interreg-nomade/IMU-v2-Hardware/README.md

# IMU-v2-Hardware

Design files can be found [here](/Design)

Manufacturing files can be found [here](/Gerber)

### Photos
Photos can be found [here](/Photos)

<p align="center">  
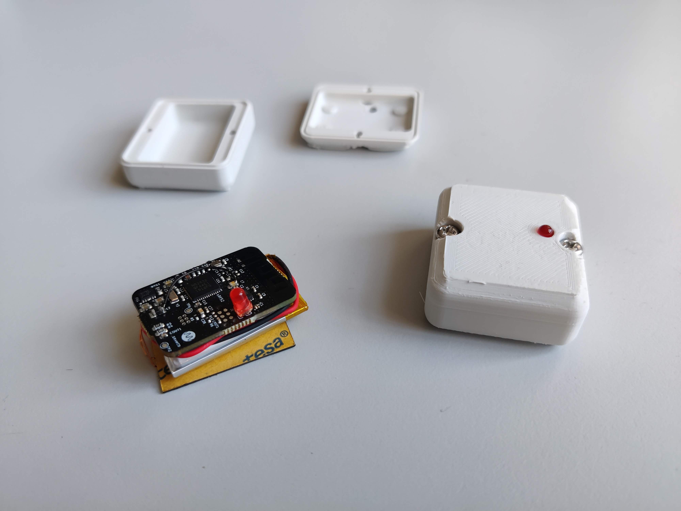
[picture p1: Photos/Internals1.jpg]

</p>
