interreg-nomade/IMU-v2-Hardware/Photos/Back.jpg

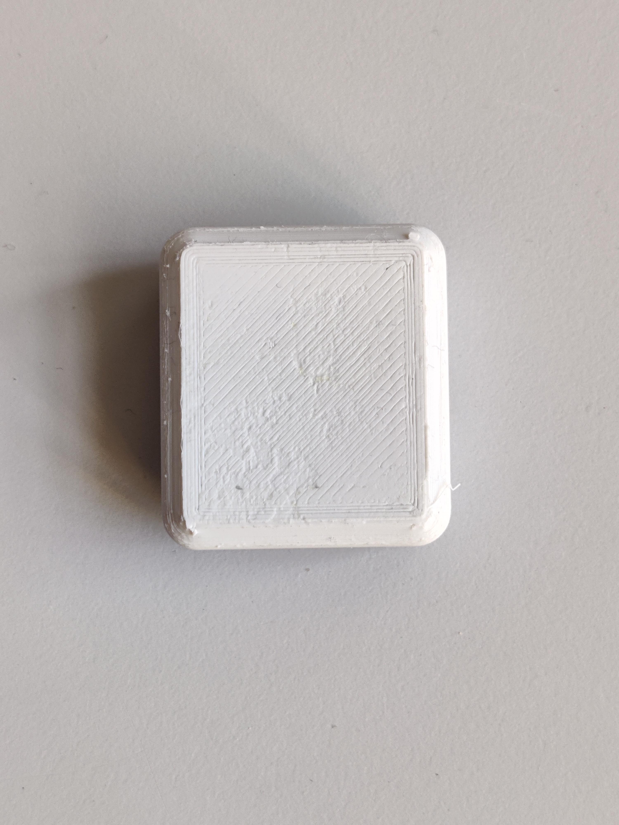
Photos/Back.jpg
