interreg-nomade/IMU-v2-Hardware/Photos/Front.jpg

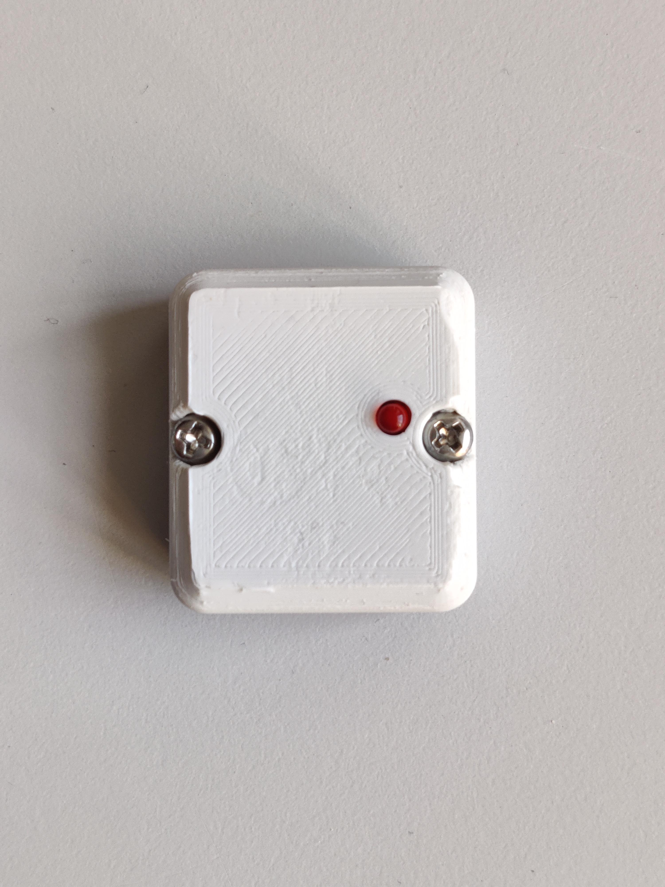
Photos/Front.jpg
