interreg-nomade/IMU-v2-Hardware/Photos/Internals2.jpg

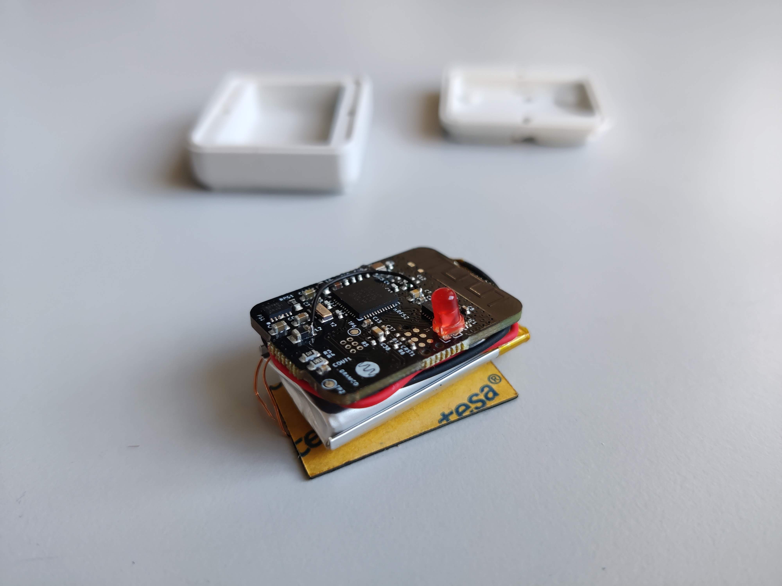
Photos/Internals2.jpg
