interreg-nomade/IMU-v2-Hardware/Photos/Internals_Bottom.jpg

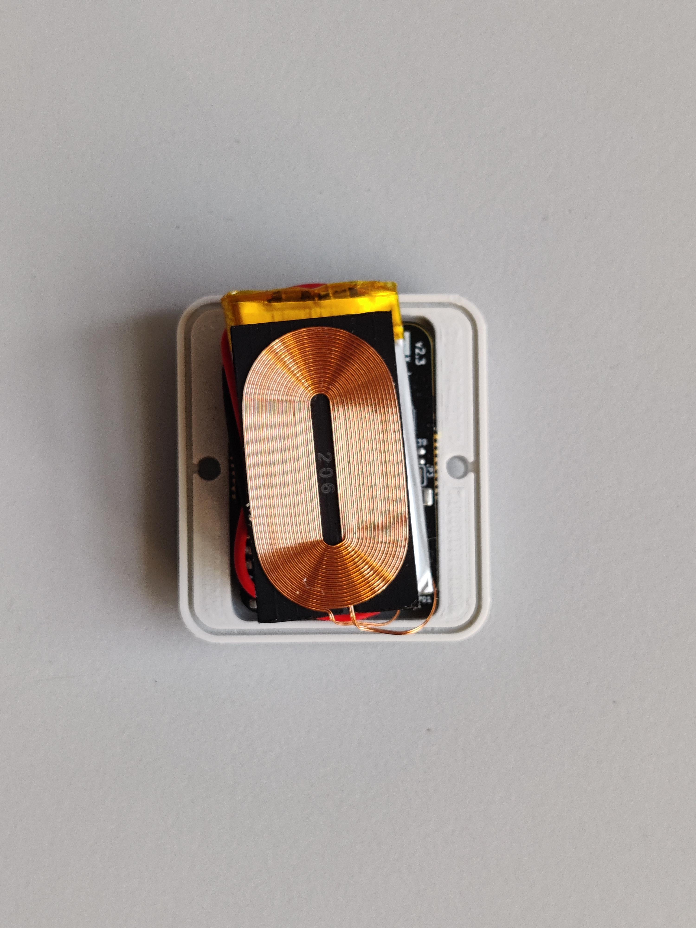
Photos/Internals_Bottom.jpg
