interreg-nomade/IMU-v2-Hardware/Photos/Internals_Top.jpg

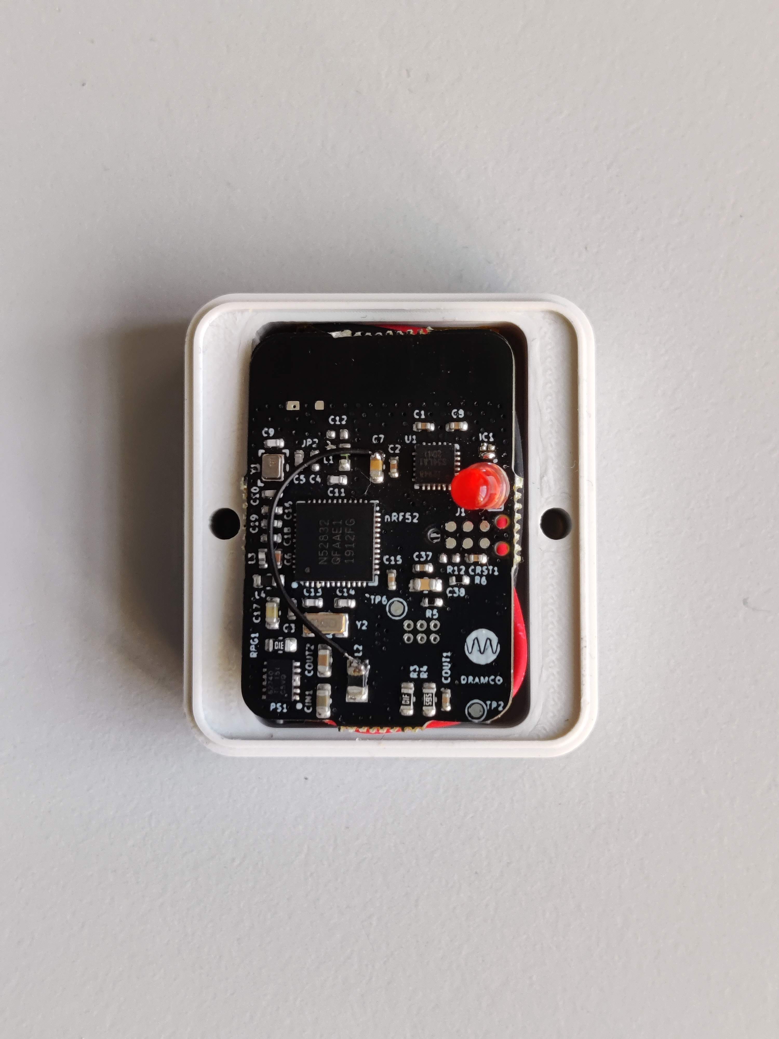
Photos/Internals_Top.jpg
