interreg-nomade/IMU-v2-Hardware/Photos/Side1.jpg

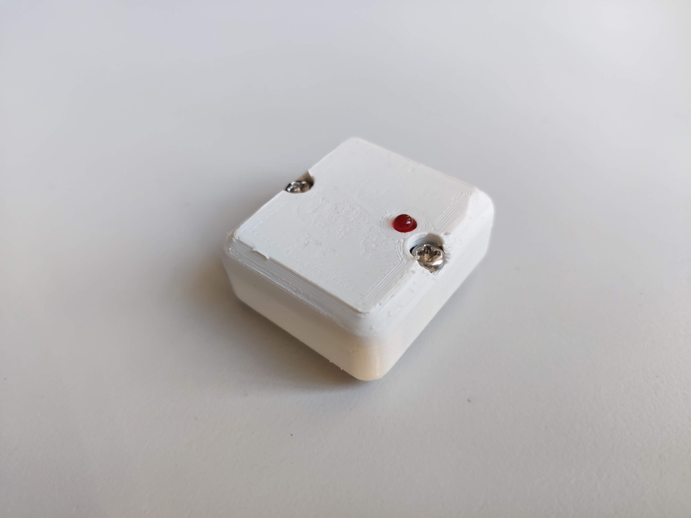
Photos/Side1.jpg
