interreg-nomade/IMU-v2-Hardware/Photos/Side2.jpg

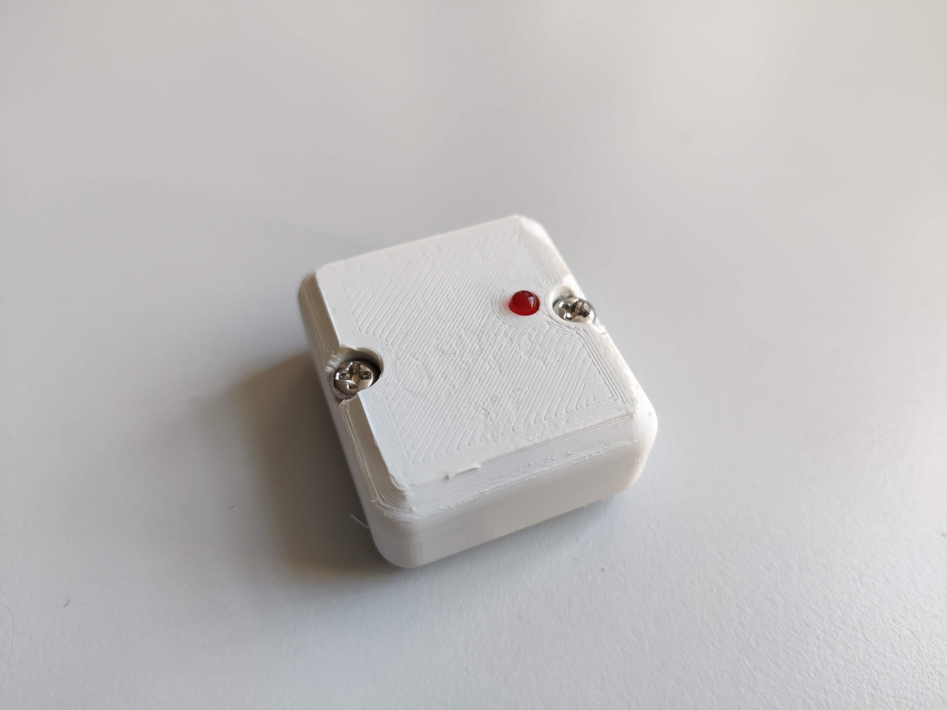
Photos/Side2.jpg
