interreg-nomade/IMU-v2-Hardware/Case/Top.STL

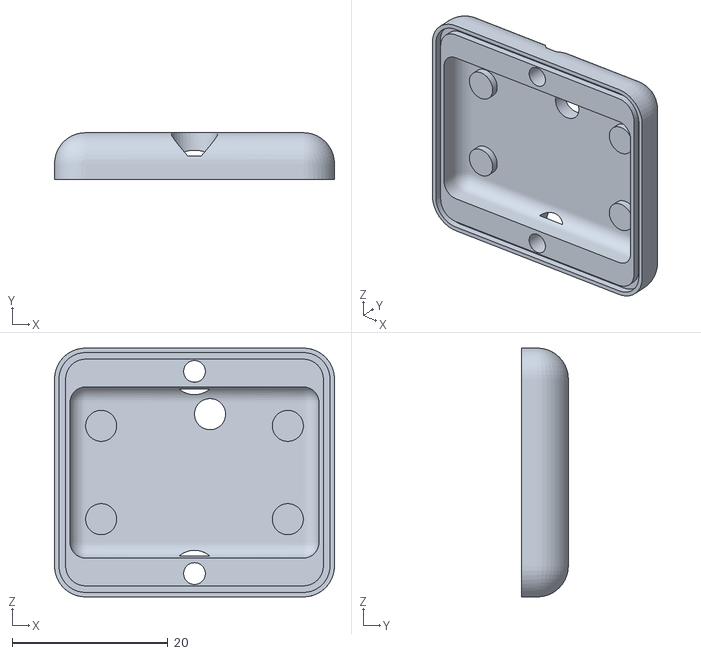
[picture p9: CAD file, 2022-03-03]
Case/Top.STL
36.0 x 6.00 x 32.0
