interreg-nomade/IMU-v2-Hardware/Case/Bottom.STL

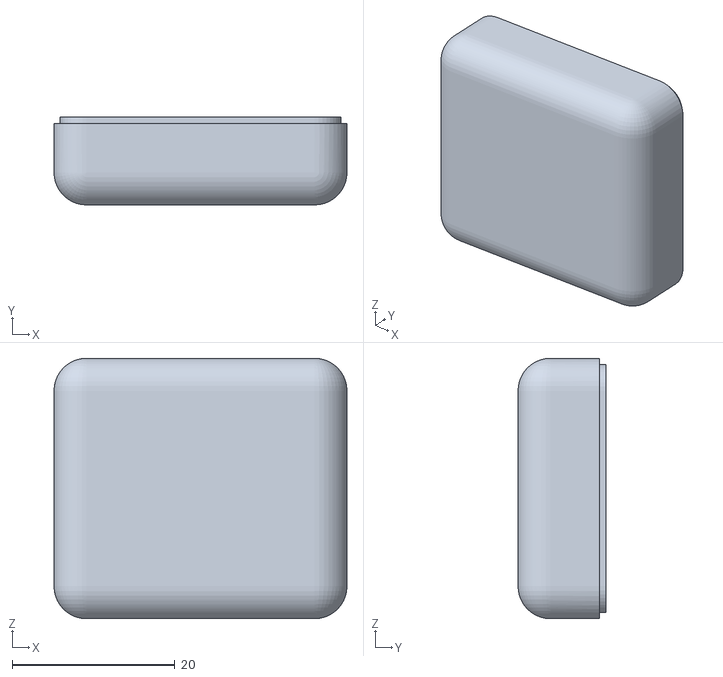
[picture p10: CAD file, 2022-03-03]
Case/Bottom.STL
36.0 x 10.8 x 32.0
