interreg-nomade/IMU-v2-Hardware/Design/NOMADe_IMU_v2_3.kicad_pcb

## KiCad design Design/NOMADe_IMU_v2_3.kicad_pcb (2022-03-03)

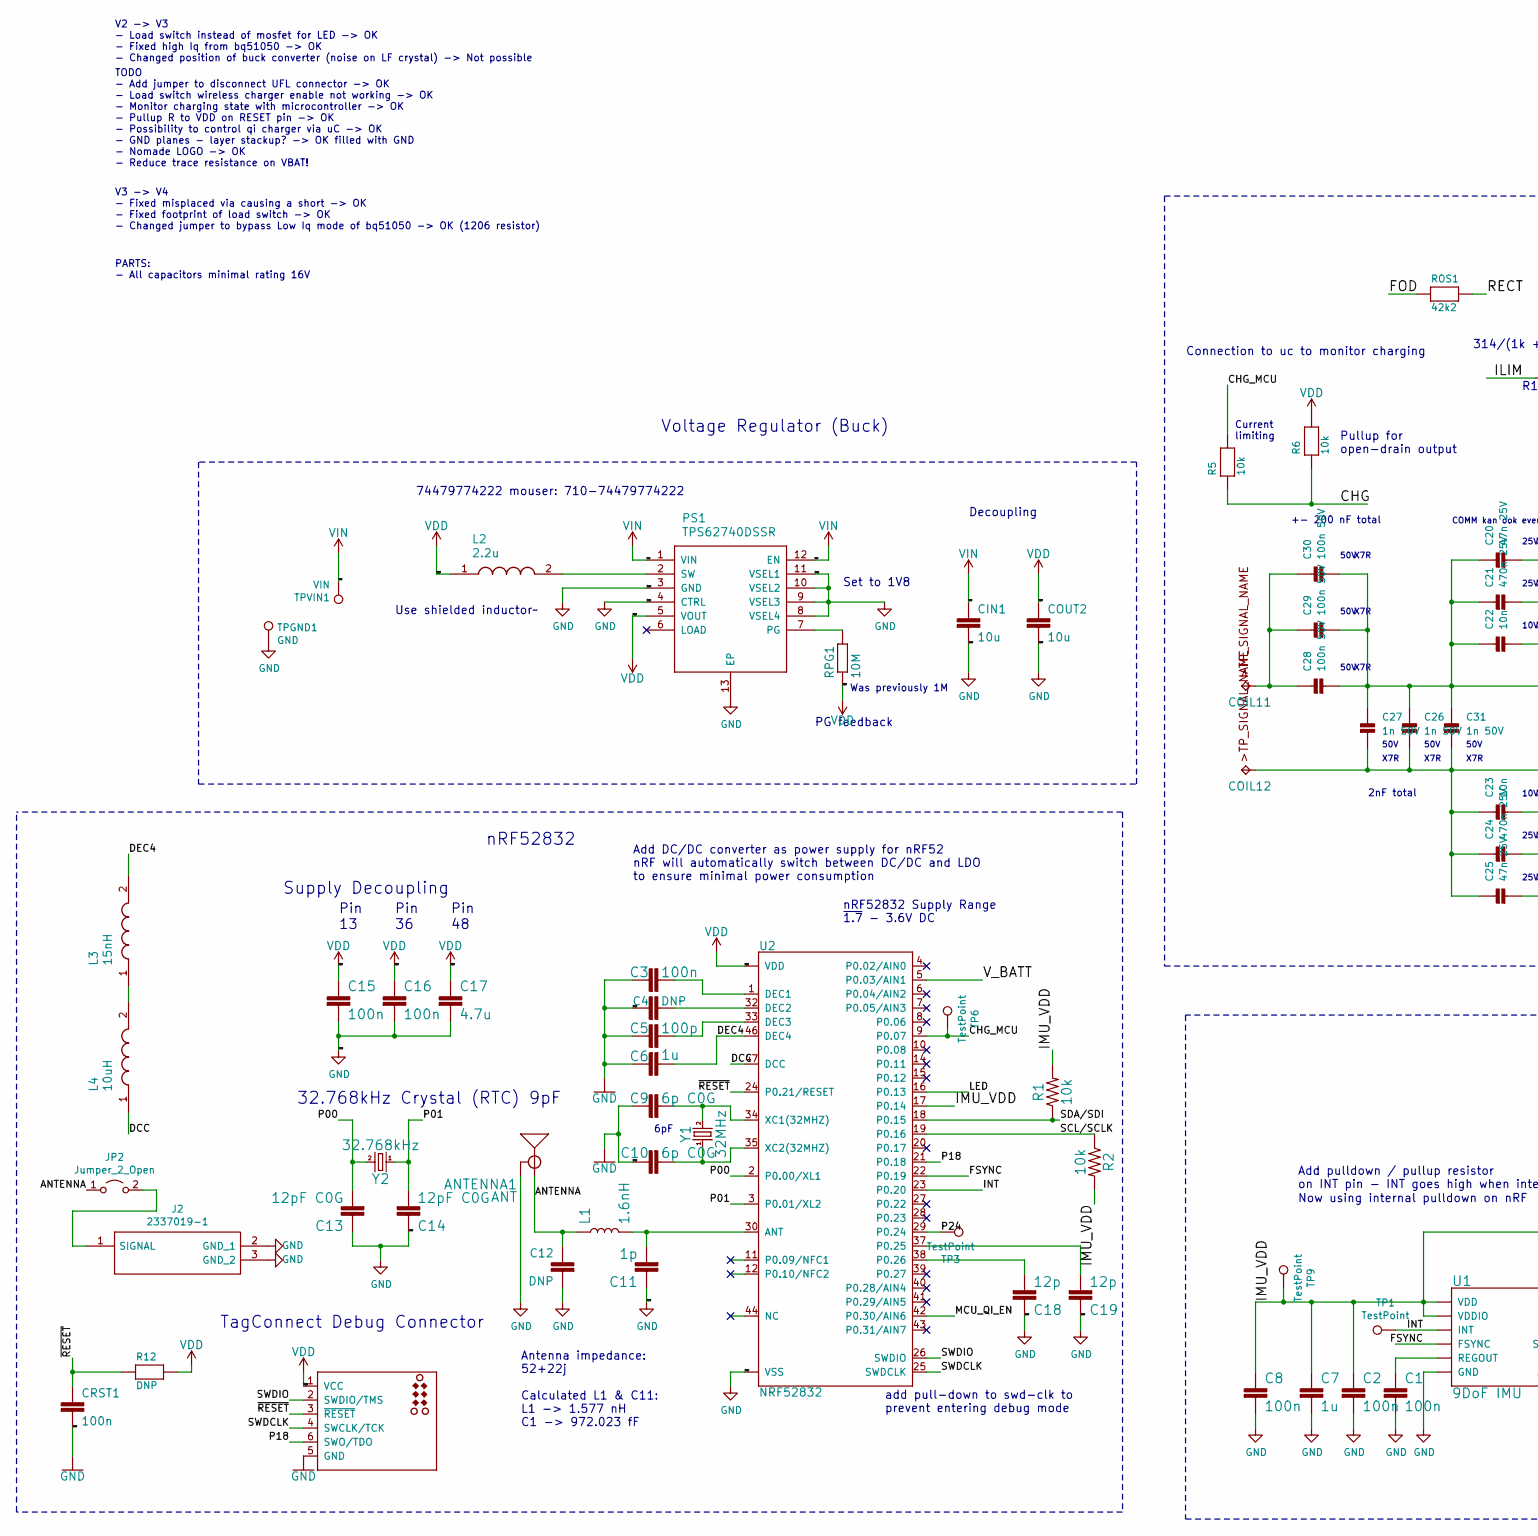
[picture p11: schematic NOMADe_IMU_v2_3.sch, NOMADe IMU v2.0, part in row 1, column 1]

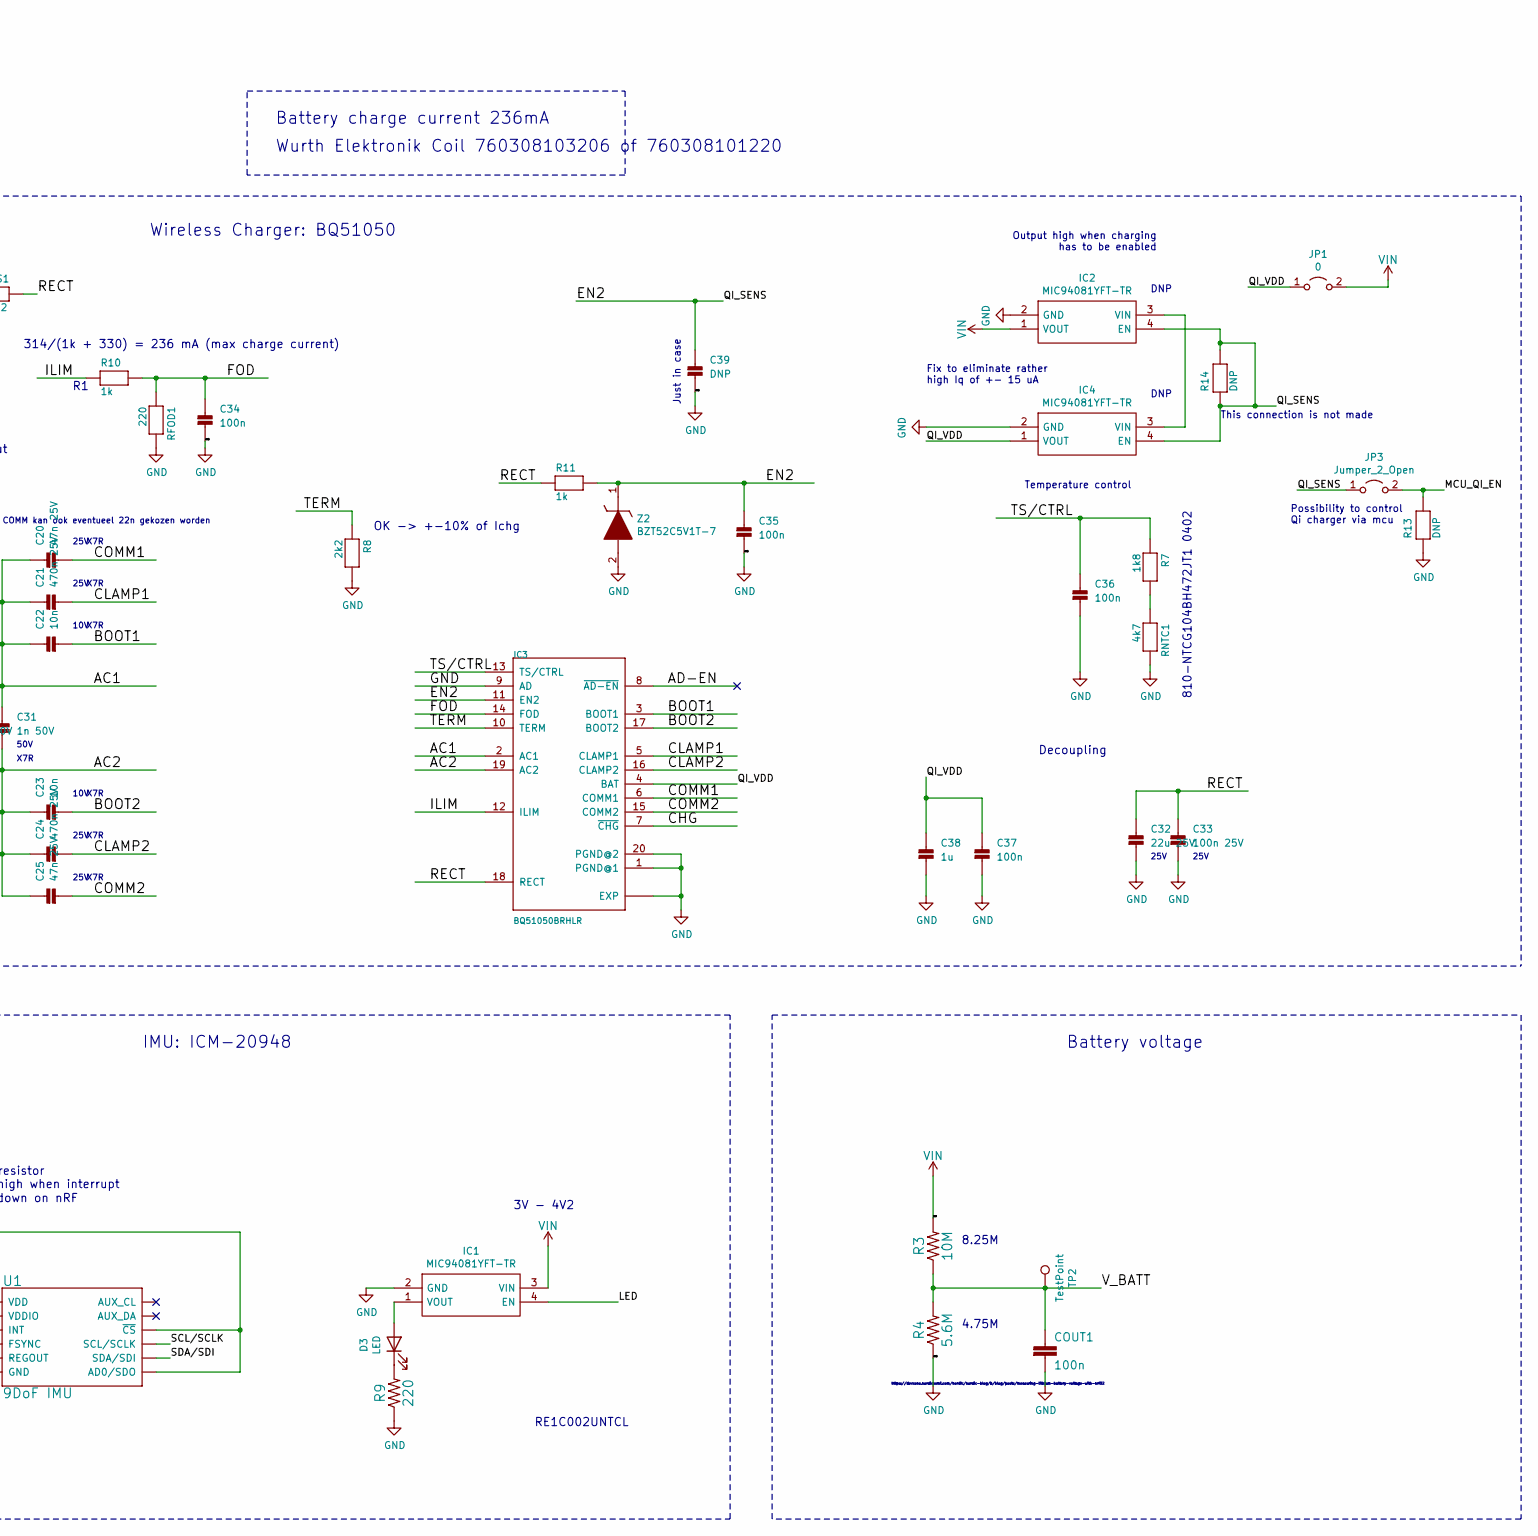
[picture p12: schematic NOMADe_IMU_v2_3.sch, NOMADe IMU v2.0, part in row 1, column 2]

Parts:
ANTENNA1: ANT; TRACE_ANTENNA_2.4GHZ_15.2MM
C1, C2, C3, C8, C15, C16, C34, C35, C36, C37: 100n; C_0402_1005Metric
C4, C12, C39: DNP; C_0402_1005Metric
C5: 100p; C_0402_1005Metric
C6: 1u; C_0402_1005Metric
C7, C38: 1u; C_0603_1608Metric
C9, C10: 6p C0G; C_0402_1005Metric
C11: 1p; C_0402_1005Metric
C13, C14: 12pF C0G; C_0402_1005Metric
C17: 4.7u; C_0603_1608Metric
C18, C19: 12p; C_0402_1005Metric
C20, C25: 47n 25V; C_0603_1608Metric
C21, C24: 470n 25V; C_0603_1608Metric
C22, C23: 10n; C_0603_1608Metric
C26, C27, C31: 1n 50V; C_0603_1608Metric
C28, C29, C30: 100n 50V; C_0603_1608Metric
C32: 22u 25V; C_0805_2012Metric
C33: 100n 25V; C_0402_1005Metric
CIN1: 10u; C_0603_1608Metric
COIL11, COIL12: TPTP10SQ; TP10SQ
COUT1: 100n; C_0402_1005Metric
COUT2: 10u; C_0603_1608Metric
CRST1: 100n; C_0402_1005Metric
D3: LED; PinHeader_1x02_P1.27mm_Vertical
IC1, IC2, IC4: MIC94081YFT-TR; Mouser Part Number 998-MIC94081YFTTR
IC3: BQ51050BRHLR; QFN50P450X350X100-21N
J1: TC2030_SWD-MCP-NL; TC2030-MCP-NL
J2: 2337019-1; 23370191; Mouser Part Number 571-2337019-1
JP1: 0; R_1206_3216Metric
JP2: Jumper_2_Open; R_0402_1005Metric
JP3: Jumper_2_Open; SMT-JUMPER_2_NO_SILK
L1: 1.6nH; 0402
L2: 2.2u; INDC2012X145N
L3: 15nH; L_0402_1005Metric
L4: 10uH; L_0603_1608Metric
PS1: TPS62740DSSR; SON50P200X300X80-13N
R1, R2, R5, R6: 10k; C_0402_1005Metric
R3: 10M; R_0603_1608Metric
R4: 5.6M; R_0603_1608Metric
R7: 1k8; R_0402_1005Metric
R8: 2k2; R_0603_1608Metric
R9: 220; R_0402_1005Metric
R10, R11: 1k; R_0603_1608Metric
R12, R13: DNP; C_0402_1005Metric
R14: DNP; R_0603_1608Metric
RFOD1: 220; R_0603_1608Metric
RNTC1: 4k7; R_0402_1005Metric
ROS1: 42k2; R_0603_1608Metric
RPG1: 10M; R_0603_1608Metric
TP1, TP2, TP3, TP6, TP9: TestPoint; TestPoint_Pad_D1.0mm
TPGND1: GND; TestPoint_Pad_2.0x2.0mm
TPVIN1: VIN; TestPoint_Pad_2.0x2.0mm
U1: 9DoF IMU; QFN24-3X3
U2: NRF52832; QFN48-6X6MM
Y1: 32MHz; CRYSTAL-SMD-2.0X1.6MM
Y2: 32.768kHz; CRYSTAL-SMD-3.2X1.5MM
Z2: BZT52C5V1T-7; SODFL1608X65N; Mouser Part Number 621-BZT52C5V1T-7

Connections:
/AC1: C20.1, C21.1, C22.1, C26.1, C27.1, C28.2, C29.2, C30.2, C31.1, IC3.2 (AC1)
/AC2: C23.1, C24.1, C25.1, C26.2, C27.2, C31.2, COIL12.TP, IC3.19 (AC2)
/AD-EN: IC3.8 (~AD-EN)
/ANTENNA: ANTENNA1.ANT (SIGNAL), C12.1, JP2.1 (A), L1.1
/BOOT1: C22.2, IC3.3 (BOOT1)
/BOOT2: C23.2, IC3.17 (BOOT2)
/CHG: IC3.7 (~CHG), R5.1, R6.1
/CHG_MCU: R5.2, TP6.1, U2.9 (P0.07)
/CLAMP1: C21.2, IC3.5 (CLAMP1)
/CLAMP2: C24.2, IC3.16 (CLAMP2)
/COMM1: C20.2, IC3.6 (COMM1)
/COMM2: C25.2, IC3.15 (COMM2)
/DCC: L4.1, U2.47 (DCC)
/DEC4: C6.2, L3.2, U2.46 (DEC4)
/EN2: C35.1, C39.1, IC2.4 (EN), IC3.11 (EN2), IC4.4 (EN), JP3.1 (A), R11.2, R14.1, R14.2, Z2.1
/FOD: C34.1, IC3.14 (FOD), R10.2, RFOD1.1, ROS1.1
/FSYNC: U1.11 (FSYNC), U2.22 (P0.19)
/ILIM: IC3.12 (ILIM), R10.1
/IMU_VDD: C2.1, C7.1, C8.1, R1.2, R2.2, TP9.1, U1.8 (VDDIO), U1.9 (AD0/SDO), U1.13 (VDD), U1.22 (~CS), U2.17 (P0.14)
/INT: TP1.1, U1.12 (INT), U2.23 (P0.20)
/LED: IC1.4 (EN), U2.16 (P0.13)
/MCU_QI_EN: JP3.2 (B), R13.2, U2.42 (P0.30/AIN6)
/P00: C13.2, U2.2 (P0.00/XL1), Y2.P$2 (2)
/P01: C14.2, U2.3 (P0.01/XL2), Y2.P$1 (1)
/P18: J1.6 (SWO/TDO), U2.21 (P0.18)
/P24: TP3.1, U2.29 (P0.24)
/QI_VDD: C37.1, C38.1, IC3.4 (BAT), IC4.1 (VOUT), JP1.1 (A)
/RECT: C32.1, C33.1, IC3.18 (RECT), R11.1, ROS1.2
/SCL/SCLK: R2.1, U1.23 (SCL/SCLK), U2.19 (P0.16)
/SDA/SDI: R1.1, U1.24 (SDA/SDI), U2.18 (P0.15)
/SWDCLK: J1.4 (SWCLK/TCK), U2.25 (SWDCLK)
/SWDIO: J1.2 (SWDIO/TMS), U2.26 (SWDIO)
/TERM: IC3.10 (TERM), R8.1
/TS/CTRL: C36.1, IC3.13 (TS/CTRL), R7.1
/V_BATT: COUT1.1, R3.1, R4.2, TP2.1, U2.5 (P0.03/AIN1)
/~RESET~: CRST1.1, J1.3 (~RESET), R12.1, U2.24 (P0.21/RESET)
GND: ANTENNA1.GND, C1.2, C2.2, C3.1, C4.1, C5.1, C6.1, C7.2, C8.2, C9.1, C10.2, C11.1, C12.2, C13.1, C14.1, C15.2, C16.2, C17.2, C18.1, C19.1, C32.2, C33.2, C34.2, C35.2, C36.2, C37.2, C38.2, C39.2, CIN1.2, COUT1.2, COUT2.2, CRST1.2, IC1.2 (GND), IC2.2 (GND), IC3.1 (PGND@1), IC3.9 (AD), IC3.20 (PGND@2), IC3.21 (EXP), IC3.22 (EXP), IC3.23 (EXP), IC3.24 (EXP), IC3.25 (EXP), IC3.26 (EXP), IC3.27 (EXP), IC3.28 (EXP), IC3.29 (EXP), IC3.30 (EXP), IC3.31 (EXP), IC3.32 (EXP), IC3.33 (EXP), IC4.2 (GND), J1.5 (GND), J2.2 (GND_1), J2.3 (GND_2), PS1.3 (GND), PS1.4 (CTRL), PS1.8 (VSEL4), PS1.9 (VSEL3), PS1.10 (VSEL2), PS1.11 (VSEL1), PS1.13 (EP), R4.1, R8.2, R9.1, R13.1, RFOD1.2, RNTC1.2, TPGND1.1, U1.18 (GND), U1.20 (GND), U2.31 (VSS), U2.45 (VSS), U2.EP (VSS), Z2.2
unnamed: C1.1, U1.10 (REGOUT)
unnamed: C3.2, U2.1 (DEC1)
unnamed: C4.2, U2.32 (DEC2)
unnamed: C5.2, U2.33 (DEC3)
unnamed: C9.2, U2.34 (XC1(32MHZ)), Y1.3 (2)
unnamed: C10.1, U2.35 (XC2(32MHZ)), Y1.1
unnamed: C11.2, L1.2, U2.30 (ANT)
unnamed: C18.2, U2.38 (P0.26)
unnamed: C19.2, U2.37 (P0.25)
unnamed: C28.1, C29.1, C30.1, COIL11.TP
unnamed: D3.1 (K), R9.2
unnamed: D3.2 (A), IC1.1 (VOUT)
unnamed: IC2.3 (VIN), IC4.3 (VIN)
unnamed: J2.1 (SIGNAL), JP2.2 (B)
unnamed: L2.2, PS1.2 (SW)
unnamed: L3.1, L4.2
unnamed: PS1.7 (PG), RPG1.2
unnamed: R7.2, RNTC1.1
VDD: C15.1, C16.1, C17.1, COUT2.1, J1.1 (VCC), L2.1, PS1.5 (VOUT), R6.2, R12.2, RPG1.1, U2.13 (VDD), U2.36 (VDD), U2.48 (VDD)
VIN: CIN1.1, IC1.3 (VIN), IC2.1 (VOUT), JP1.2 (B), PS1.1 (VIN), PS1.12 (EN), R3.2, TPVIN1.1

Notes on the sheet:
nRF52832
TagConnect Debug Connector
nRF52832 Supply Range ~1.7 - 3.6V DC~
74479774222 mouser: 710-74479774222
Decoupling
Set to 1V8
PG feedback
Voltage Regulator (Buck)
IMU: ICM-20948
3V - 4V2
RE1C002UNTCL
Add pulldown / pullup resistor on INT pin - INT goes high when interrupt
Add DC/DC converter as power supply for nRF52 nRF will automatically switch between DC/DC and LDO to ensure minimal power consumption
Use shielded inductor~~
add pull-down to swd-clk to prevent entering debug mode
4.75M
8.25M
https://devzone.nordicsemi.com/nordic/nordic-blog/b/blog/posts/measuring-lithium-battery-voltage-with-nrf52
Now using internal pulldown on nRF
Antenna impedance: 52+22j Calculated L1 & C11: L1 -> 1.577 nH C1 -> 972.023 fF
10V
25V
COMM kan ook eventueel 22n gekozen worden
50V
X7R
314/(1k + 330) = 236 mA (max charge current)
Wurth Elektronik Coil 760308103206 of 760308101220
Battery charge current 236mA
Wireless Charger: BQ51050
Connection to uc to monitor charging
OK -> +-10% of Ichg
810-NTCG104BH472JT1 0402
Output high when charging has to be enabled
2nF total
+- 200 nF total
TODO - Add jumper to disconnect UFL connector -> OK - Load switch wireless charger enable not working -> OK - Monitor charging state with microcontroller -> OK - Pullup R to VDD on RESET pin -> OK - Possibility to control qi charger via uC -> OK - GND planes - layer stackup? -> OK filled with GND -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
32.768kHz Crystal (RTC) 9pF
Supply Decoupling
Pin 48
Pin 36
Pin 13
V2 -> V3 - Load switch instead of mosfet for LED -> OK - Fixed high Iq from bq51050 -> OK - Changed position of buck converter (noise on LF crystal) -> Not possible
Pullup for open-drain output
Current limiting
Just in case
Fix to eliminate rather high Iq of +- 15 uA
Temperature control
Possibility to control Qi charger via mcu
V3 -> V4 - Fixed misplaced via causing a short -> OK - Fixed footprint of load switch -> OK - Changed jumper to bypass Low Iq mode of bq51050 -> OK (1206 resistor)
This connection is not made
PARTS: - All capacitors minimal rating 16V
Battery voltage
6pF
DNP
Was previously 1M

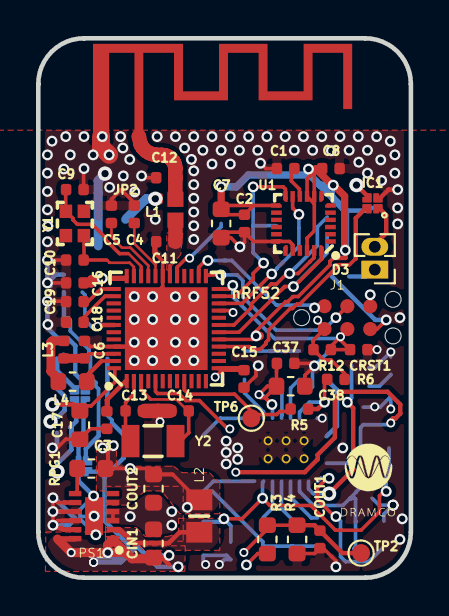
[picture p13: board NOMADe_IMU_v2_3.kicad_pcb from above]

Board: 4 copper layers, 20.7 x 30.0 mm, 91 parts (0 on the bottom side), 56 nets.
