interreg-nomade/IMU-v2-Hardware/(commit log)

2022-03-03 Design files PCB
    [NOMADe_IMU_v2_3.kicad_pcb, NOMADe_IMU_v2_3.sch]
2022-03-03 3D prints case
    [Bottom.STL, Top.STL]
