interreg-nomade/IMU-v2-Hardware/(notices)

Notices in the files:
parts and their libraries:
Copyright 2021 Accelerated Designs. All rights reserved.
©2009 ROFA.cz - modified and updated by Robert Darlington ‹rdarlington@gmail.com›
